ptrkhh/xc7kodok/docs/connectors.csv

rank | part | type | shop_link | datasheet_link | price | pitch_mm | pitch_status | con_n | con_n_status | con_w | con_w_status | con_h | con_h_status | con_d | con_d_status | con_tip | con_tip_status | con_tip_y | con_tip_y_status | finger_w | finger_w_status | travel_mm | travel_status | force | contact_direction | compatible | notes
1 | Samsung 3711-009829 (XCover 7 OEM, 6 contacts) | side-contact leaf, SMD | https://2repair.parts/product/samsung-2x6-pin-battery-connector-2-5mm-33262 |  | call for price (UK) | 2.5 | real | 6 | estimated | 16 | estimated |  | unknown |  | unknown |  | unknown |  | unknown | 0.9-1.2 | estimated |  | unknown |  | side (parallel to PCB) | yes (OEM mate) | Fits SM-G556/SM-G766/Tab Active5 per listing. 6 contacts with double fingers from photo. con_w = 6x2.5 + ~1 guess. Not found on Tokopedia; try 'konektor baterai xcover 7' / 'G556'.
2 | Samsung J5 2016 / J1 2016 battery connector | side-contact leaf, SMD | https://www.tokopedia.com/cibinong/konektor-baterai-samsung-j5-2016-di-mesin-fpc-battery-samsung-j5-2016 |  | Rp15.000 | 2.5 | estimated | 4 | real (photo) |  | unknown |  | unknown |  | unknown |  | unknown |  | unknown | 0.9-1.2 | estimated |  | unknown |  | side (parallel to PCB) | likely | Pitch inferred from Samsung naming '3711-008086 Battery Connector 2.5mm'. Measure pin1-pin3 = 5.0 mm on arrival. Body dimensions unknown; photos suggest side contact | unlike the BC-25-3P (contacts normal to PCB).
2 | Samsung J2 Prime / Grand Prime 4-pin battery connector | side-contact leaf, SMD | https://www.tokopedia.com/cibinong/konektor-baterai-samsung-j2-prime-4-pin-samsung-grand-prime-grand-1pcs |  | Rp14.500 | 2.5 | estimated | 4 | real (listing+photo) |  | unknown |  | unknown |  | unknown |  | unknown |  | unknown | 0.9-1.2 | estimated |  | unknown |  | side (parallel to PCB) | likely | 2repair lists Grand Prime under 3-pin 3711-008086; listing says 4 pin. Measure before use.
2 | Samsung S3 i9300 / S4 i9500 4-pin battery connector | side-contact leaf, SMD | https://www.tokopedia.com/alya-spareparthp/samsung-s3-i9300-s4-i9500-konektor-baterai-4-pin-dimesin-fpc-battery |  | Rp14.500 | 2.5 | estimated | 4 | real (listing+photo) |  | unknown |  | unknown |  | unknown |  | unknown |  | unknown | 0.9-1.2 | estimated |  | unknown |  | side (parallel to PCB) | likely | S4 in 3711-008086 compatibility list.
2 | Samsung 3711-008086 (3-pin, J1/J5/J7/S4/S5/G530/G360/XCover 5/XCover Pro) | side-contact leaf, SMD | https://2repair.parts/product/samsung-battery-connector-2-5mm-8977 |  |  | 2.5 | estimated | 3 | real (photo) |  | unknown |  | unknown |  | unknown |  | unknown |  | unknown | 0.9-1.2 | estimated |  | unknown |  | side (parallel to PCB) | likely | '2.5mm' in part name, not confirmed to be pitch.
3 | Hroparts BC-25-3P-170 / -200 (LCSC C707322) | PCB-normal leaf spring, SMD (per drawing) | https://www.lcsc.com/product-detail/C707322.html | https://datasheet.lcsc.com/datasheet/pdf/8153bae77de8ce951813d5d88903037f.pdf?productCode=C707322 | USD 0.27 @5 | 2.5 | real | 3 | real | 7.5 | real | 5.0 | real (installed Y depth) | 1.7 / 2.0 | real (DIM A; installed Z housing height) | 1.35+/-0.2 | real (DIM B minus DIM A; free protrusion) | 3.75 | drawing-derived nominal apex; measure sweep | 0.9 | real |  | unknown (not specified) |  | vertical (normal to PCB; PCB face down) | nominal fit; measure actual part | Defaults use -170. DIM A=1.7/2.0 housing height; DIM B=3.05/3.35 total height. 4.20 is horizontal spring extent, not housing height. Working stroke and force unverified. Mount PCB face down, tips up. 2 A, 12 V, 5000 cycles.
3 | Kyocera AVX 009155003001016 (9155-000 series, 3/4/5 pos) | side-contact leaf, SMD | https://www.digikey.com/en/products/result?keywords=009155003001016 | https://datasheets.kyocera-avx.com/Standard2.5mmPitch_9155-000.pdf | ~USD 1.35 | 2.5 | real | 3/4/5 | real |  | unknown | 3.0 | real (insulator height) |  | unknown | 1.65 / 2.10 / 2.60 | real (pair meaning interpreted) |  | unknown |  | unknown | 0.45-0.5 | estimated |  | side (horizontal mating) | yes | Contact height options 1.20/1.65, 1.80/2.10, 2.30/2.60 mm; read as compressed/free. Get sales drawing for con_w/con_d. 3 A, 5000 cycles.
4 | Multicomp Pro MP015217 pogo 3P (MP015218 = 4P) | pogo pin, vertical THT | https://www.farnell.com/ | https://farnell.com/datasheets/4459682.pdf |  | 2.54 | real | 3 | real | 7.6 | real | 2.5 | real | 1.5 | real | 1.5 | estimated (3.0 total - 1.5 housing) | 1.25 | real (centered in strip) | 0.9 | real (plunger dia) | 0.8 | real (3.0 free - 2.2 working) | 100+/-30 gf | vertical (axis normal to PCB) | yes | Mount strip flat, tips up: con_w=L, con_h=W, con_d=H. Tails 1.5 mm below housing (pocket open at bottom). 4P: con_w 10.2.
4 | HECON HC-PGC-E2.54 right-angle pogo (e.g. -065-XX-11, 3P) | pogo pin, right-angle THT |  | https://p.globalsources.com/IMAGES/PDT/SPEC/709/K1226645709.pdf |  | 2.54 | real | 3 | real (1-16 available) | 7.62 | estimated (3 x 2.54) | 2.5 | real | 4.5 | real (H) | 2.0 | estimated (A 6.5 - H 4.5) | 1.25 | estimated | 1.0 | real (plunger dia) | 1.0 | real (stroke) | 70+/-20 gf | side (axis parallel to PCB) | yes | Variants: A 5.5-8.5, H 4.5/5.5, full stroke 1.4. con_tip = A - H. Typical of generic 'pogo pin 2.54 right angle'.
4 | Mill-Max 825 (vertical) / 829 (horizontal) pogo, 2.54 | pogo pin, THT | https://www.mill-max.com/products/socket/825-XX-XXX-10-002101 | https://www.mill-max.com/products/socket/829-XX-XXX-20-002101 |  | 2.54 | real |  | per order code |  | unknown |  | unknown |  | unknown |  | unknown |  | unknown |  | unknown | 2.286 | real |  | vertical (825) / side (829) | yes | Initial height 8.433 mm (825, real); 829 conflicting 8.433 vs 10.312. Expensive.
4 | Generic 5 pcs pogo pin header 2.54 single row THT | pogo pin, vertical THT | https://www.tokopedia.com/panpang-bebek/5-pcs-male-spring-loaded-pogo-pin-header-female-target-connectors-2-54mm-grid-2-3-4-5-6-7-8-10-positions-through-hole-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 |  | Rp262.000 | 2.54 | real (listing) | 2-10 | real (listing) |  | unknown |  | unknown |  | unknown |  | unknown |  | unknown |  | unknown |  | unknown |  | vertical | yes | Import reseller, expensive. Shopee/AliExpress cheaper.
4 | PGC-1.5-4.8-RA-3P-2.5PH right-angle pogo 3P | pogo pin, right-angle | https://www.tokopedia.com/mheru/pogo-factory-direct-sale-3-pin-3p-connector-spring-needle-large-current-gold-plated-pin-pgc-1-5-4-8-ra-3p-2-5ph-17327760388650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 |  | Rp7.6 jt (placeholder?) | 2.5 | estimated (from part name) | 3 | real (listing) |  | unknown |  | unknown |  | unknown |  | unknown |  | unknown |  | unknown |  | unknown |  | side | likely | Part name suggests 1.5 dia, 4.8 length, 2.5 pitch. No readable specs.
5 | Nokia BL-5C connector (Nokia 3100 / 105 family), 3 blade | side-contact blade | https://www.tokopedia.com/cibinong/konektor-baterai-nokia-3100-jadul-3-pin-kaki |  | Rp11.500-12.000 | 2.54 / 3.0 / 3.1 | unknown (sources conflict) | 3 | real (photo) |  | unknown |  | unknown |  | unknown |  | unknown |  | unknown |  | unknown |  | unknown |  | side | no | At 3.0 pitch pin 3 lands on pad 3 edge (charger.scad assert fails at pin 2). Blades made for slotted BL-5C contacts. Nokia 105 2019 (TA-1174) Shopee link blocked (HTTP 403).
