ptrkhh/xc7kodok/stl/car_arm.stl

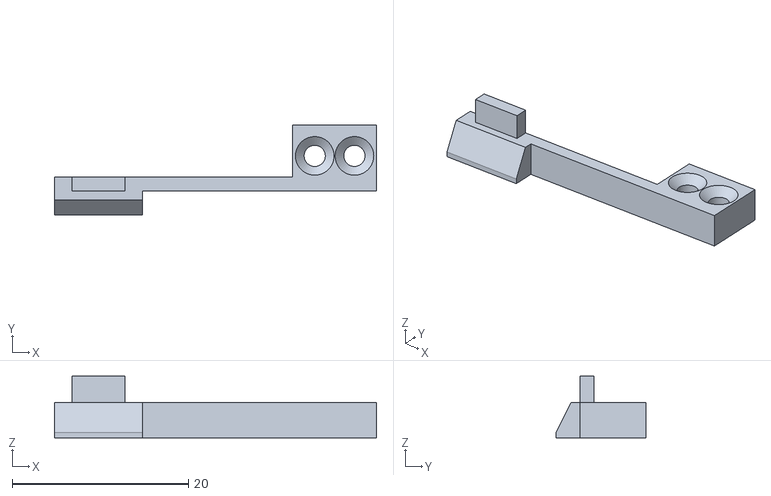
[picture p3: CAD file, 2026-10-13]
stl/car_arm.stl
36.5 x 10.2 x 6.99
