ptrkhh/xc7kodok/XC7 battery.SLDPRT

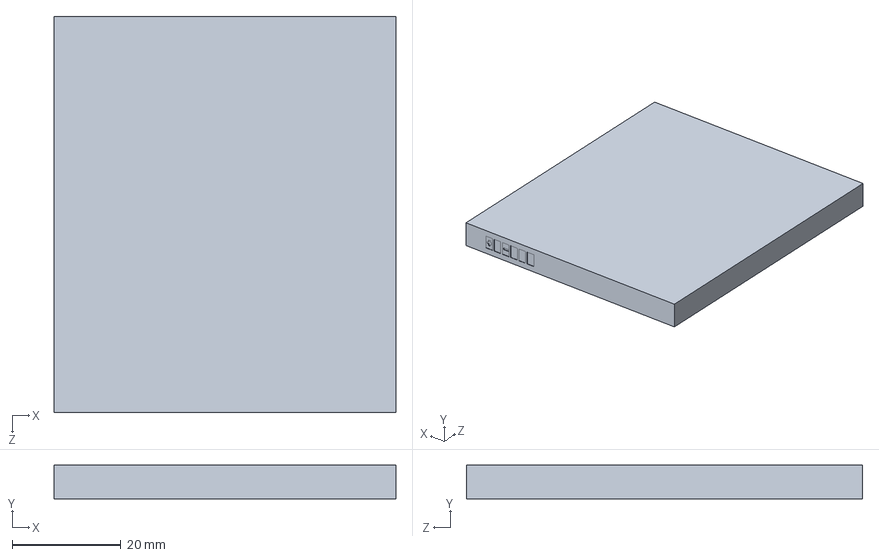
[picture p4: CAD file, 2026-10-13]
XC7 battery.SLDPRT
63.0 x 6.25 x 73.0 mm
