ptrkhh/xc7kodok/stl/car_bottom.stl

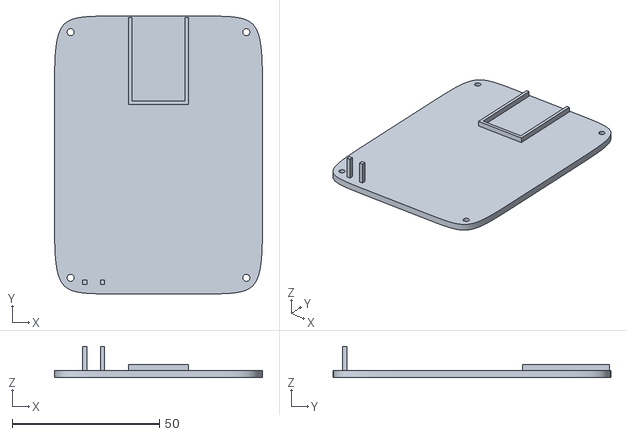
[picture p5: CAD file, 2026-10-13]
stl/car_bottom.stl
70.6 x 94.3 x 10.7
