ptrkhh/xc7kodok/stl/car_cradle.stl

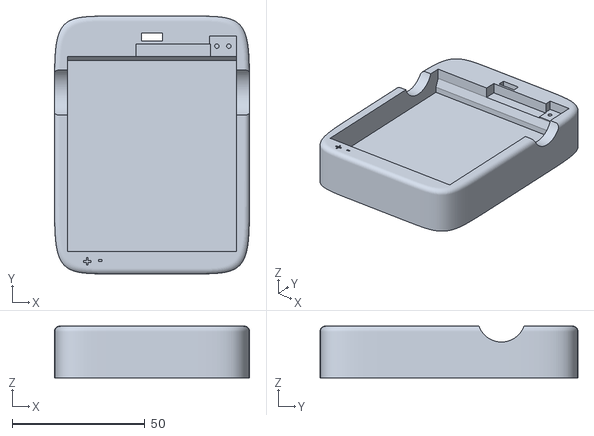
[picture p6: CAD file, 2026-10-13]
stl/car_cradle.stl
73.6 x 97.3 x 19.5
