ptrkhh/xc7kodok/stl/cradle.stl

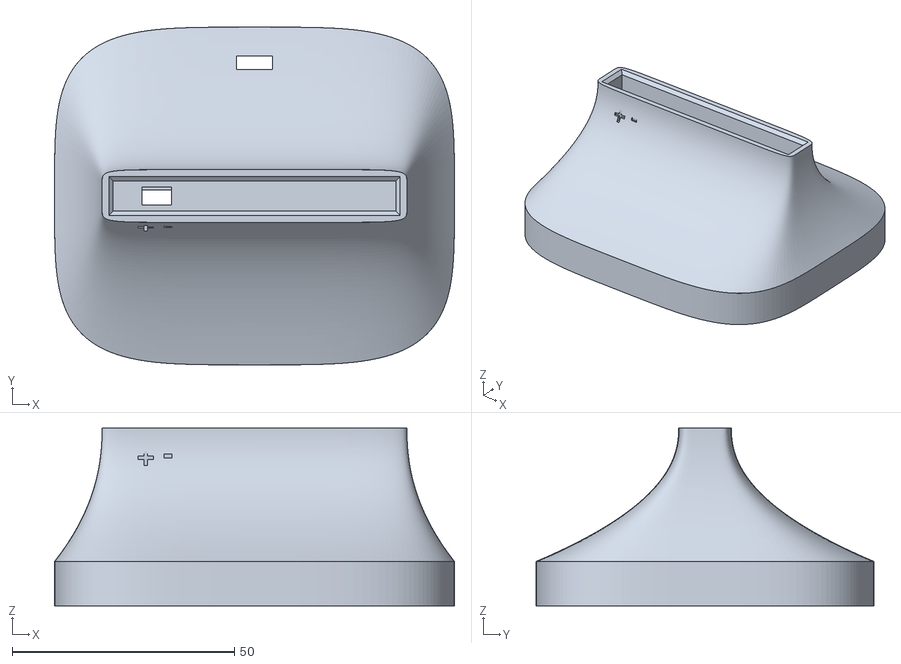
[picture p7: CAD file, 2026-10-13]
stl/cradle.stl
90.0 x 76.0 x 40.0
