ptrkhh/xc7kodok/stl/bottom.stl

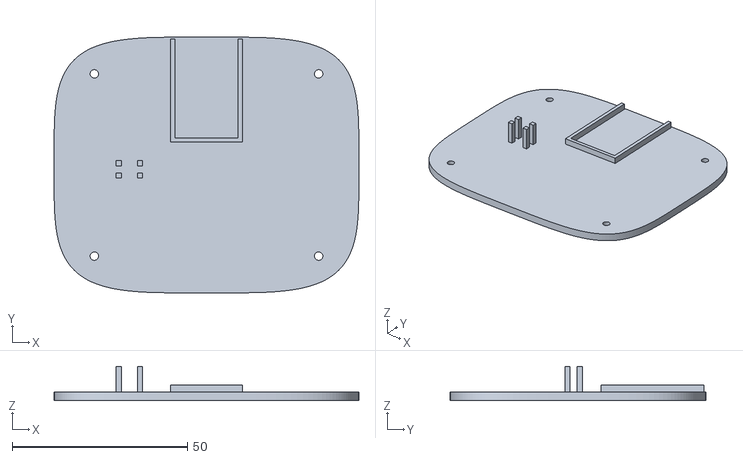
[picture p8: CAD file, 2026-10-13]
stl/bottom.stl
87.0 x 73.0 x 9.75
