ptrkhh/xc7kodok/archive/original-basic-version/bottom.stl

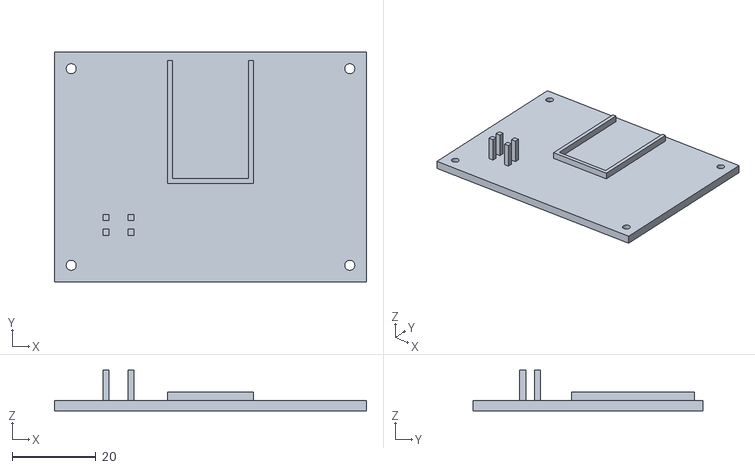
[picture p9: CAD file, 2026-10-13, an earlier design]
archive/original-basic-version/bottom.stl
74.6 x 55.0 x 9.75
