ptrkhh/xc7kodok/archive/original-basic-version/cradle.stl

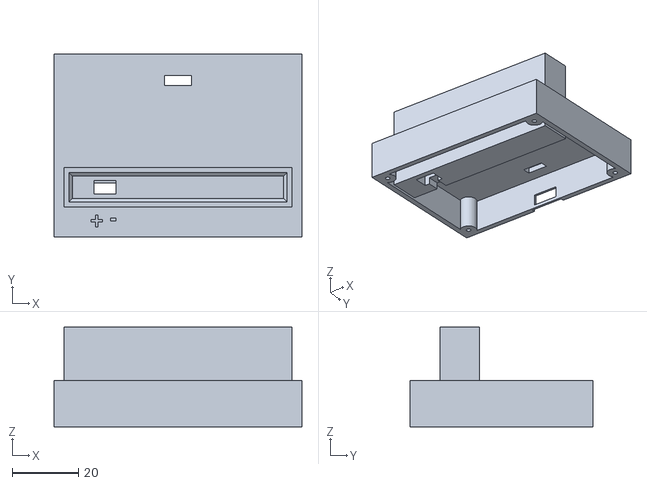
[picture p10: CAD file, 2026-10-13, an earlier design]
archive/original-basic-version/cradle.stl
74.6 x 55.0 x 30.0
