ptrkhh/xc7kodok/(list of files, cad)

Other CAD files:
archive/original-basic-version/charger.scad
