ptrkhh/xc7kodok/(commit log)

2026-10-13 Initial commit: XCover 7 battery cradle and car mount (OpenSCAD)
    Parametric desktop cradle and glove-box variant for the Samsung
    XCover 7 battery with TP4056 USB-C charger module. Includes STL
    exports, previews, regression tests, review ledgers, and the
    earlier basic-version snapshot under archive/.
    Claude-Session: https://claude.ai/code/session_01D43r5rpbvjcwbHTdzmhCYC
    [XC7 battery.SLDPRT, bottom.stl, car.scad, car_arm.stl, car_bottom.stl, car_cradle.stl, charger.scad, connectors.csv]
2026-10-14 docs: drop stale proprietary and no-git wording from review ledgers
    The SLDPRT battery model was created by the owner, not a proprietary
    third-party file. The repo now exists, so the no-Git statements are
    scoped to review time.
    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
